Rokas-Mar/gesture-pad/MacroSense.kicad_pcb

## KiCad design MacroSense.kicad_pcb (2026-11-03)

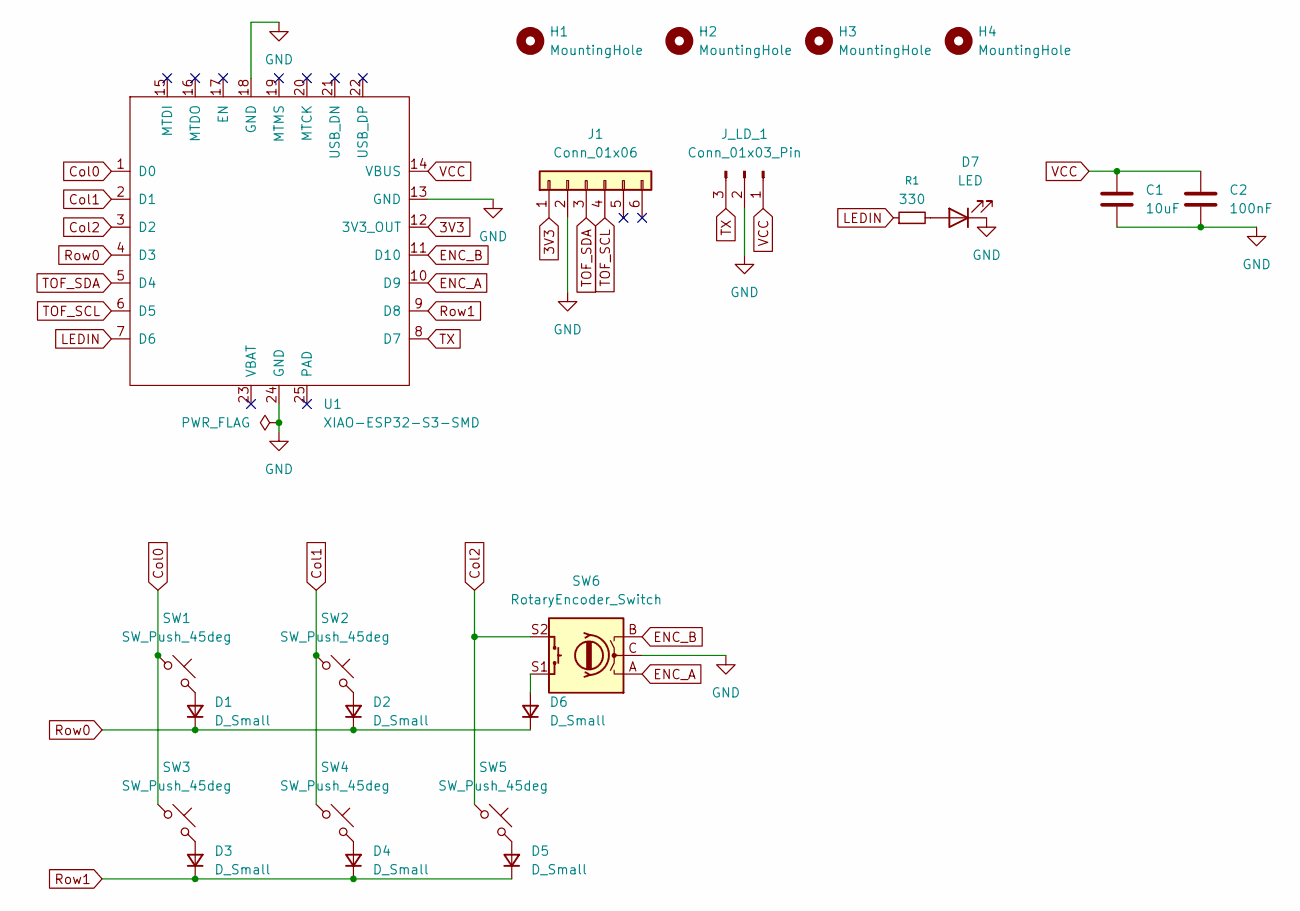
[picture p1: schematic MacroSense.kicad_sch]

Parts:
C1: 10uF; C_0603_1608Metric
C2: 100nF; C_0603_1608Metric
D1, D2, D3, D4, D5, D6: D_Small; D_SOD-123
D7: LED; LED_0603_1608Metric
H1, H2, H3, H4: MountingHole; MountingHole_4.3mm_M4
J1: Conn_01x06; PinHeader_1x06_P2.54mm_Vertical
J_LD_1: Conn_01x03_Pin; PinHeader_1x03_P2.54mm_Vertical
R1: 330; R_0603_1608Metric
SW1, SW2, SW3, SW4, SW5: SW_Push_45deg; SW_MX_HS_CPG151101S11_1u
SW6: RotaryEncoder_Switch; RotaryEncoder_Alps_EC11E-Switch_Vertical_H20mm
U1: XIAO-ESP32-S3-SMD

Connections:
3V3: J1.1, U1.12 (3V3_OUT)
Col0: SW1.1, SW3.1, U1.1 (D0)
Col1: SW2.1, SW4.1, U1.2 (D1)
Col2: SW5.1, SW6.S2, U1.3 (D2)
ENC_A: SW6.A, U1.10 (D9)
ENC_B: SW6.B, U1.11 (D10)
GND: C1.2, C2.2, D7.1 (K), J1.2, J_LD_1.2, SW6.C, U1.13 (GND), U1.18 (GND), U1.24 (GND)
LEDIN: R1.1, U1.7 (D6)
unnamed: D1.2 (A), SW1.2
unnamed: D2.2 (A), SW2.2
unnamed: D3.2 (A), SW3.2
unnamed: D4.2 (A), SW4.2
unnamed: D5.2 (A), SW5.2
unnamed: D6.2 (A), SW6.S1
unnamed: D7.2 (A), R1.2
Row0: D1.1 (K), D2.1 (K), D6.1 (K), U1.4 (D3)
Row1: D3.1 (K), D4.1 (K), D5.1 (K), U1.9 (D8)
TOF_SCL: J1.4, U1.6 (D5)
TOF_SDA: J1.3, U1.5 (D4)
TX: J_LD_1.3, U1.8 (D7)
VCC: C1.1, C2.1, J_LD_1.1, U1.14 (VBUS)

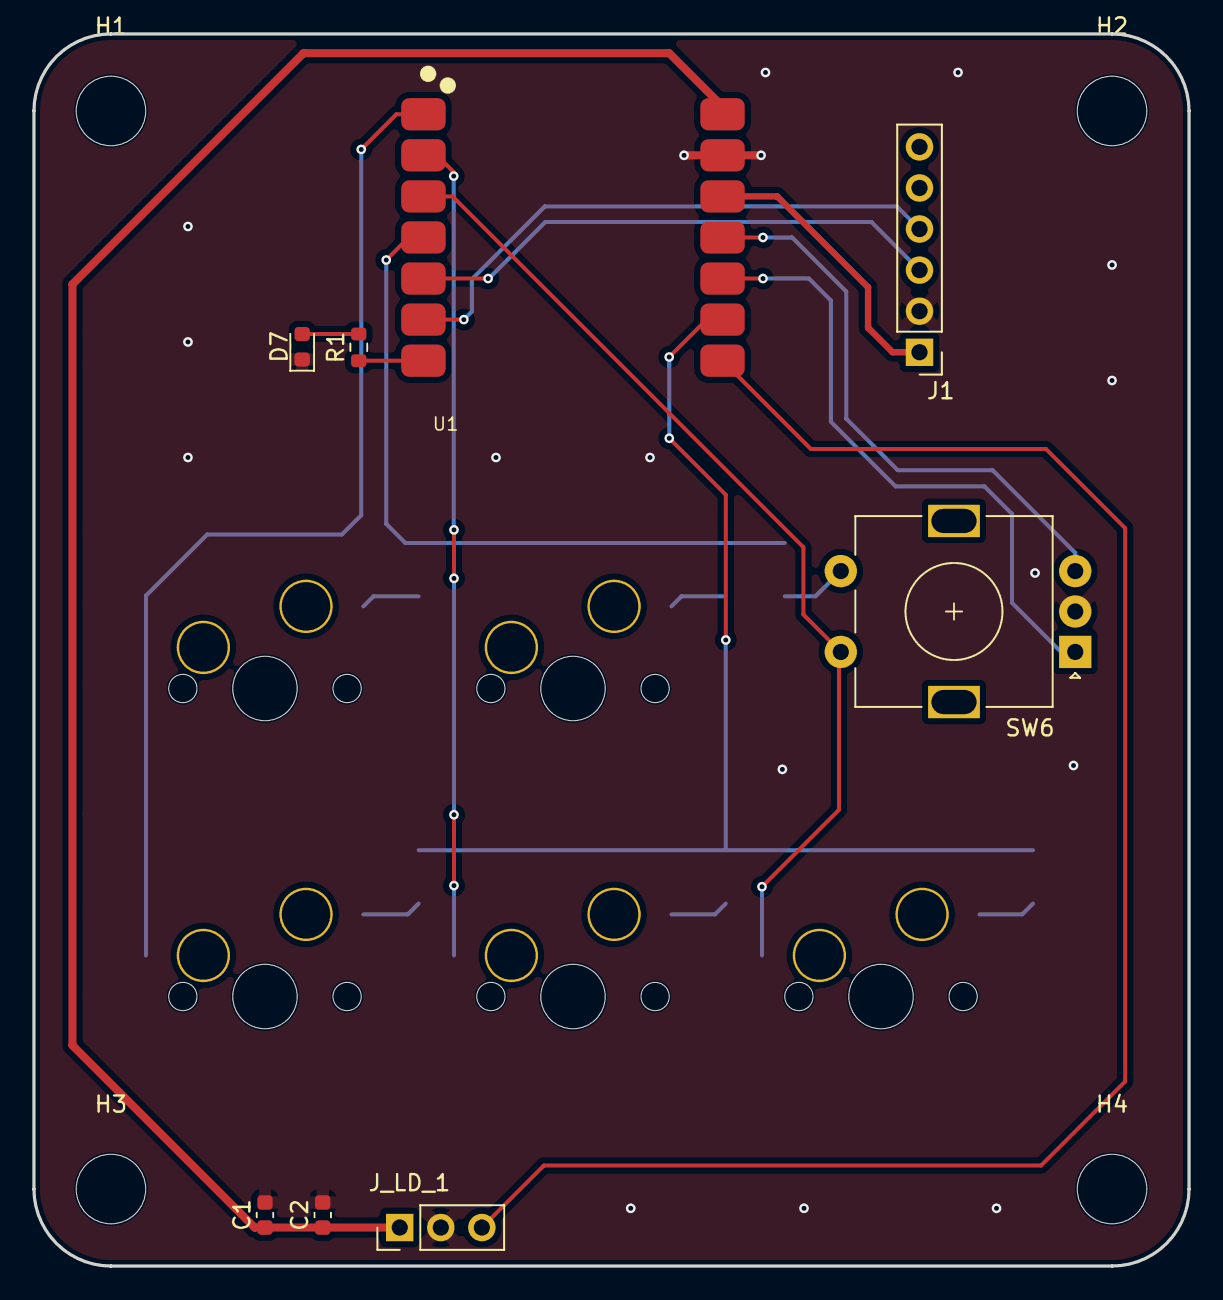
[picture p2: board MacroSense.kicad_pcb from above]

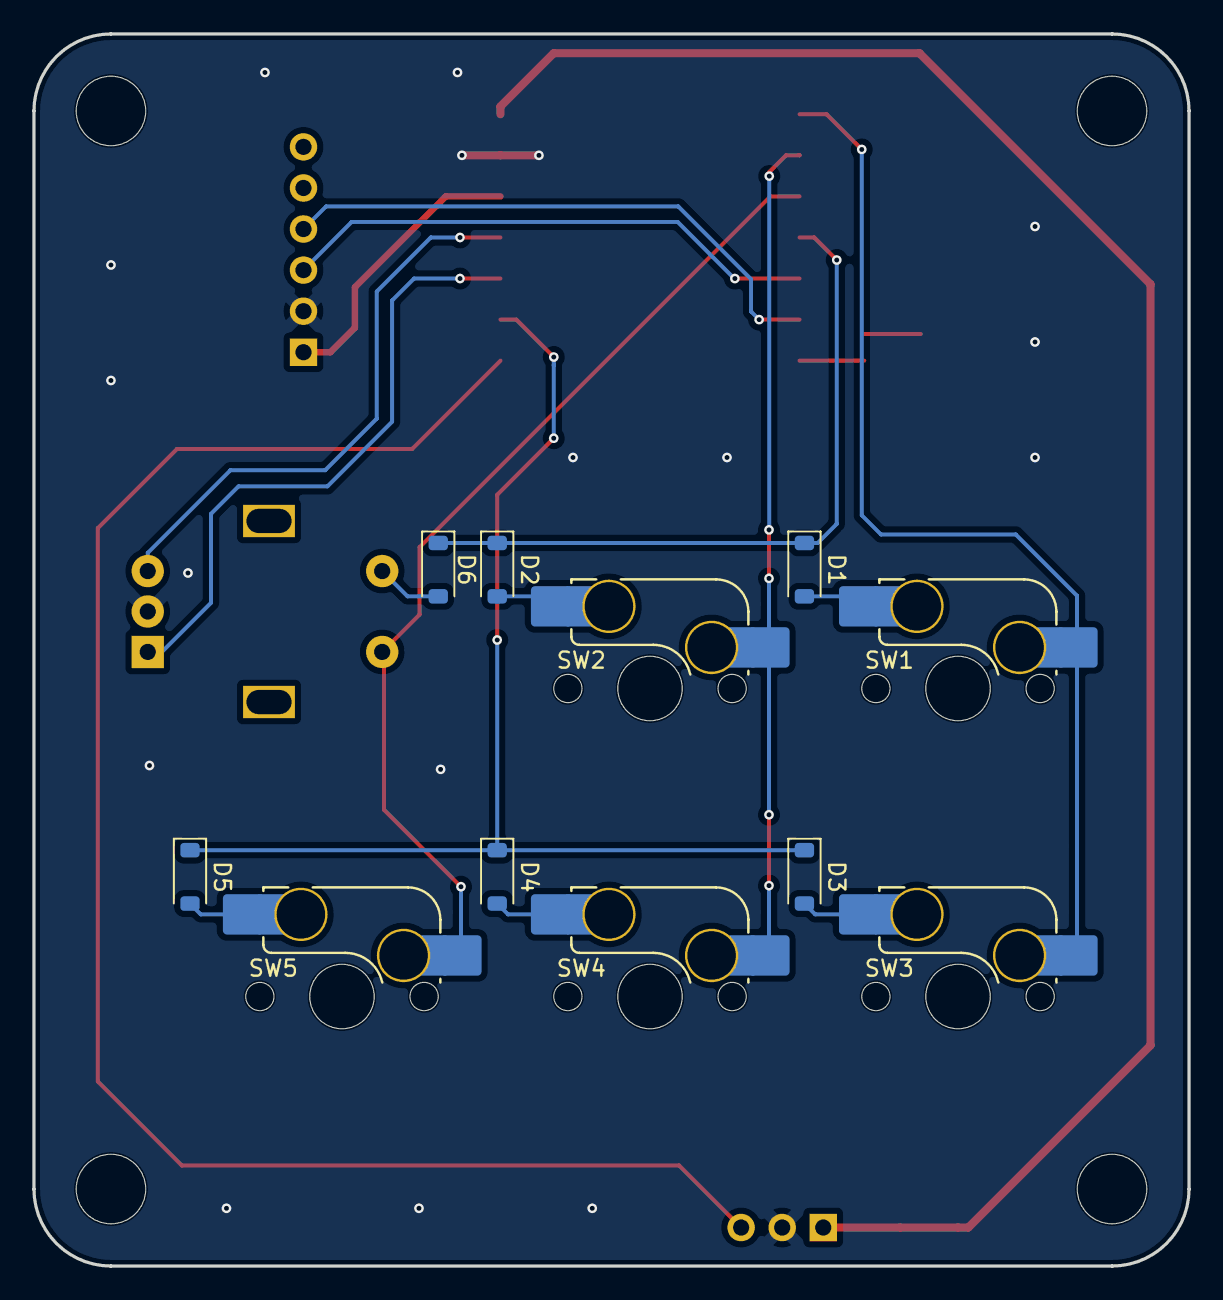
[picture p3: board MacroSense.kicad_pcb from below]

Board: 2 copper layers, 71.4 x 76.2 mm, 23 parts (11 on the bottom side), 21 nets.
